SebastianoMeduri/cpld_can_ioexpander/doc/technical_report.html

Report Tecnico · Sviluppo PCB

# I/O Expander su CAN Bus

Intel MAX V · 5M1270ZT144C4 · TQFP-144 · CAN 2.0A @ 500 kbit/s

Controller CAN 2.0A, 32 I/O bidirezionali, funzione di sicurezza a doppio canale e 8 encoder incrementali, interamente in VHDL, sintetizzato e validato in simulazione. Questo documento raccoglie tutto il necessario per il progetto della scheda: pinout, alimentazioni, componenti esterni, temporizzazione e risultati funzionali.

Device5M1270Z

PackageTQFP-144

Clock20 MHz

Bitrate500 kbit/s

Logic~99% (fit)

I/O util.59 pin

Encoder8 × A/B

Sicurezza2 canali

Fault conf.TEC/REC

Sintesi0 errori

SimulazionePASS

Rev. 1.0 Data 2026-07-18 Toolchain Quartus Prime Lite 21.1 Sim GHDL 6.0.0 (VHDL-2008) Convenzione bus 0 = dominante, 1 = recessivo

01 Panoramica

## Architettura del sistema

Il dispositivo si collega al bus CAN tramite un transceiver PHY esterno e mette a disposizione 32 pin configurabili singolarmente come ingresso o uscita, comandabili e leggibili via messaggi CAN. Il protocollo CAN è realizzato interamente nella logica del CPLD (bit timing, bit stuffing, CRC-15, arbitraggio, ACK); non serve alcun microcontrollore né controller CAN dedicato.

Gerarchia RTL. can_ioexpander_top istanzia il controller CAN (sincronizzatore + bit timing + MAC) e l'espansore I/O. Interfaccia fisica a 2 fili (can_txd/can_rxd) verso il transceiver.

02 Target & risorse

## Dispositivo e occupazione

#### Dispositivo

- Famiglia: Intel MAX V (CPLD flash-based, non volatile)
- Part number: 5M1270ZT144C4 (grado C4/C5/A5 intercambiabile — stesso package)
- Logic Element: 1270 · UFM: 8 Kbit (disponibile, non usata)
- Package: TQFP-144, 114 I/O utente
- Config: ISP via JTAG, file .pof (nessuna config flash esterna)

#### Occupazione (post-fit)

Logic cells *~99% *

Pin I/O59 / 114

Interconnessioni~24 % med.

* Con tutte le funzioni la prima sintesi era al 103% (non entrava). Dopo le ottimizzazioni (latch TX rimossi nel MAC; sync I/O a 1FF che abilita il register packing negli IOE) la compilazione ENTRA: Fitter ok, timing rispettato, ~99% (leggere il valore esatto nel fit report). Margine minimo — per headroom vedere le riduzioni in fondo.

### Analisi statica dei tempi (STA) — vincolo clock 20 MHz (50 ns)

Margini positivi su tutti i domini. Il progetto lavora a 20 MHz con ampio margine; nessun percorso critico. Setup +34.4 ns, hold +1.13 ns, min-pulse +24.8 ns.

03 Temporizzazione CAN

## Bit timing — 20 time quanta per bit

Con clock a 20 MHz e prescaler BRP = 2, un time quantum (Tq) vale 100 ns. Il tempo di bit è diviso in 20 Tq (1 SYNC + 15 TSEG1 + 4 TSEG2), pari a 2 µs → 500 kbit/s. Il campionamento avviene all'80 % del bit; la finestra di risincronizzazione (SJW) è 3 Tq.

Parametri configurabili via generic (BRP, TSEG1, TSEG2, SJW) nel top level: per un clock diverso basta ricalcolare BRP affinché 1 bit = NTQ × Tq = 1/bitrate.

04 Formato trama

## Trama dati CAN 2.0A (identificatore standard 11 bit)

Campo dati fino a 8 byte. L'applicazione usa 4 byte (32 bit = i 32 pin). Il CRC-15 (polinomio 0x4599) copre da SOF a fine dati; il bit stuffing agisce su SOF…CRC.

05 Protocollo applicativo

## Messaggi e mappatura dei pin

Identificatore a 11 bit strutturato come FUNC(3) · NODE(4) · 0000. Gli ID esadecimali sotto valgono per node_addr = 0001.

Set di messaggi
Funzione | FUNC | ID (node 1) | Dir. | DLC | Payload
CONFIG | 010 | 0x210 | host → exp | 4 | data[63:32] = maschera direzione (1 = uscita)
OUTPUT | 001 | 0x110 | host → exp | 4 / 8 | data[63:32] = valori uscite; con DLC 8 data[31:0] = maschera di scrittura
REQUEST | 011 | 0x310 | host → exp | 0 | richiede invio immediato dello STATUS
STATUS | 100 | 0x410 | exp → host | 4 | data[63:32] = stato dei pin (uscite pilotate + ingressi letti)

Notifica automatica. Lo STATUS viene inviato spontaneamente al variare di un pin configurato come ingresso — non serve polling. Il REQUEST resta disponibile per una lettura a comando.

Mappatura payload → pin: il pin i corrisponde al bit 32 + i della trama a 64 bit. Byte0 (data[63:56]) = pin 31…24 · Byte1 = pin 23…16 · Byte2 = pin 15…8 · Byte3 = pin 7…0.

06 Pinout — TQFP-144

## Assegnazione dei pin

Layout organizzato per banco: controllo/comunicazione sul banco 1 (un lato del package), 32 I/O contigui sui banchi 3+2 (due lati adiacenti → connettore I/O unico). Banco 4 e i pin liberi restano per espansioni future. Standard I/O: 3.3-V LVTTL.

Segnali di controllo e comunicazione — Banco 1
Segnale | Pin | Dir. | Descrizione
clk | 18 | in | Global clock dedicato — oscillatore 20 MHz
rst_n | 16 | in | Reset asincrono attivo basso
can_rxd | 20 | in | Da RXD del transceiver CAN
can_txd | 21 | out | Verso TXD del transceiver CAN
node_addr[0] | 22 | in | Indirizzo nodo (strap/dip-switch)
node_addr[1] | 23 | in | Indirizzo nodo
node_addr[2] | 24 | in | Indirizzo nodo
node_addr[3] | 27 | in | Indirizzo nodo
led_error | 28 | out | Diagnostica: LED su fault CAN persistente
safe_ch1 | 29 | in | Sicurezza canale 1 (consenso attivo alto, pull-down est.)
safe_ch2 | 30 | in | Sicurezza canale 2 (consenso attivo alto, pull-down est.)

Bus I/O bidirezionale — Banchi 3 + 2 (pin contigui 73…111)
Sig. | Pin | Bank | Sig. | Pin | Bank
io[0] | 73 | 3 | io[16] | 94 | 3
io[1] | 74 | 3 | io[17] | 95 | 3
io[2] | 75 | 3 | io[18] | 96 | 3
io[3] | 76 | 3 | io[19] | 97 | 3
io[4] | 77 | 3 | io[20] | 98 | 3
io[5] | 79 | 3 | io[21] | 101 | 3
io[6] | 80 | 3 | io[22] | 102 | 3
io[7] | 81 | 3 | io[23] | 103 | 3
io[8] | 84 | 3 | io[24] | 104 | 3
io[9] | 85 | 3 | io[25] | 105 | 3
io[10] | 86 | 3 | io[26] | 106 | 3
io[11] | 87 | 3 | io[27] | 107 | 3
io[12] | 88 | 3 | io[28] | 108 | 3
io[13] | 89 | 3 | io[29] | 109 | 2
io[14] | 91 | 3 | io[30] | 110 | 2
io[15] | 93 | 3 | io[31] | 111 | 2

Ingressi non pilotati. I pin usati come ingresso vanno provvisti di resistori di pull esterni (o di una sorgente che li piloti sempre): al reset la direzione di default è ingresso/alta impedenza e i CPLD non tollerano ingressi flottanti.

Funzione di sicurezza (doppio canale fail-safe). safe_ch1 e safe_ch2 sono consensi attivi-alti: le uscite sono abilitate solo se entrambi sono alti. Se uno qualsiasi va basso (E-stop, filo interrotto, mancanza segnale) tutte le uscite vengono forzate a livello basso con override combinatorio, indipendentemente dai comandi CAN; il ripristino è automatico al ritorno del consenso e ogni transizione genera una trama STATUS. Usare pull-down esterni così che la perdita di segnale porti allo stato sicuro.

8 encoder incrementali (quadratura A/B). Ingressi enc_a[7:0] / enc_b[7:0] su banco 4, PIN 37–55 (coppie A/B adiacenti). Decodifica x4, contatori 16-bit con segno, trasmissione periodica su CAN (2 trame ENC_DATA, periodo configurabile via comando) e azzeramento via comando. Per encoder con canale di indice Z servirebbero pin aggiuntivi (non implementato).

07 Alimentazione & pin dedicati

## Alimentazioni, massa e JTAG

Pin di alimentazione / dedicati
Funzione | Tensione | Pin
VCCINT (core) | 1.8 V | 19, 56, 90, 126
VCCIO banco 1 | 3.3 V | 9, 25
VCCIO banco 4 | 3.3 V | 46, 64
VCCIO banco 3 | 3.3 V | 82, 100
VCCIO banco 2 | 3.3 V | 116, 136
GND (I/O) | 0 V | 10,11,26,47,65,78,83,99,115,135
GND (core) | 0 V | 17, 54, 92, 128
JTAG TMS / TDI / TCK / TDO | 3.3 V | 33 / 34 / 35 / 36

#### Regole di scheda

- Due tensioni: 1.8 V (core) e 3.3 V (tutti e 4 i VCCIO). Nessun pin MSEL/config (CPLD flash).
- Disaccoppiamento: 100 nF vicino a ogni pin VCCINT/VCCIO + bulk 4.7–10 µF per rail.
- JTAG: header 10-pin standard Altera per programmazione ISP del .pof.
- Sequenza di accensione: MAX V tollerante; consigliata 1.8 V prima o insieme a 3.3 V.
- Reset: rst_n con RC + eventuale supervisore.

08 Schema di collegamento

## Componenti esterni

BOM minima esterna: transceiver CAN 3.3 V, oscillatore 20 MHz, terminazione 120 Ω (agli estremi del bus), header JTAG, dip-switch indirizzo + pull, resistori di pull sugli I/O usati come ingresso, pull-down sui due ingressi di sicurezza (loss-of-signal → stop), disaccoppiamento.

#### Transceiver

- Scegliere una parte 3.3 V (SN65HVD230, MCP2562FD…) per compatibilità con le VCCIO 3.3 V.
- Terminazione 120 Ω ai due estremi fisici del bus.
- Split-termination + cap opzionale per EMC.

#### Indirizzo & diagnostica

- node_addr[3:0] via dip-switch a 4 vie con pull (definisce l'ID del nodo).
- led_error → LED + resistore di limitazione.
- Prevedere test-point su can_txd/can_rxd per debug con oscilloscopio.

09 Risultati di simulazione

## Validazione funzionale — due nodi su bus wired-AND

Il testbench collega un nodo host e il dispositivo (DUT) sullo stesso bus CAN modellato in wired-AND, ed esercita l'intero stack: framing, arbitraggio, CRC-15, bit stuffing, ACK e la logica applicativa. Esito: tutti i test superati.

Sequenza validata. Ogni trama include l'attesa IFS del nodo trasmittente. Lo STATUS a 652.5 µs è generato spontaneamente dal DUT dopo il cambio dell'ingresso io[0], e ricevuto correttamente dall'host (ACK + CRC ok).

Log della simulazione (GHDL 6.0.0)
t (sim) | Evento | Verifica
40.5 µs | Host invia CONFIG (dir = 0xFFFF0000) | ACK ok
255.7 µs | Host invia OUTPUT (0xBEEF sui pin alti) | ACK ok
477.1 µs | Verifica uscite del DUT | io[31:16] = 0xBEEF ✓
477.1 µs | Forzato ingresso io[0] = 1 | —
652.5 µs | DUT invia STATUS spontaneo, ricevuto dall'host | 0xBEEF0001 ✓
728.5 µs | Iniezione bit/stuff error (bus forzato dominante) | error frame ✓
951.7 µs | Recupero: nuova OUTPUT applicata dopo l'errore | io[31:16] = 0x1234 ✓
1137.8 µs | Trama a ID esteso 29 bit (2.0B passive) | ACK + ignorata ✓
1279 µs | Sicurezza: apertura canale 1 → uscite forzate low | io = 0x0000 ✓
1280 µs | Ripristino + apertura canale 2 (ridondanza) | low + recover ✓
1990 µs | Encoder 0: 8 impulsi avanti → letto via ENC_DATA | enc0 = +8 ✓
2756 µs | ENC_RESET encoder 0 → conteggio azzerato | enc0 = 0 ✓
2756 µs | *** TUTTI I TEST SUPERATI *** (run_exit = 0)

Coperto: SOF · arbitraggio · campo controllo · dati · CRC-15 · bit stuffing/de-stuffing · ACK · EOF · sincronizzazione bit-timing tra nodi indipendenti · CONFIG/OUTPUT/STATUS + notifica automatica · rilevazione errore, error frame e recupero (fault confinement) · tolleranza trame estese 2.0B passive · funzione di sicurezza a doppio canale (uscite a low, auto-ripristino) · 8 encoder in quadratura (conteggio, TX periodica, azzeramento).

10 Note, limiti & roadmap

## Limitazioni note e passi successivi

#### Limitazioni del core

- CAN 2.0A (ID 11 bit) + 2.0B passive: le trame estese 29 bit sono tollerate e confermate ma non trasmesse. La trasmissione di ID estesi non è supportata.
- Fault confinement presente (TEC/REC, error-active/passive/bus-off + recupero, error frame attivi/passivi). Residui: no overload frame, no suspend-transmission 8-bit, regole TEC/REC ridotte.
- Un solo buffer TX / RX (una trama per volta), sufficiente per l'applicazione I/O.

#### Roadmap (già predisposta)

- Configurazione via USB: bridge USB→UART esterno + core UART/registri.
- Persistenza: EEPROM/flash SPI esterna (node_addr, direzioni, default, bitrate).
- Pin liberi riservati: banco 4 e resto del banco 2 → UART + SPI.

Occupazione al limite. Con tutte le funzioni il 5M1270 (il piu' grande MAX V in TQFP-144) e' quasi pieno. Se dopo le ottimizzazioni il Fitter resta >100%, opzioni in ordine di impatto: (1) contatori encoder a 12 bit (−32 LE), (2) rimuovere l'auto-STATUS su cambio ingresso / registro last_rep (−32 LE), (3) capture RX a shift-register, (4) meno I/O o meno encoder, (5) device piu' grande in package diverso (es. MAX 10, richiede redesign scheda).

Stato di maturità. Lato logica il progetto e' funzionalmente completo e validato in simulazione (0 errori, timing OK, tutti i test superati). Da verificare il fit finale in Quartus dopo le ottimizzazioni. I passi rimanenti sono di scheda (transceiver, alimentazioni, connettori, JTAG).

cpld_can_ioexpander · Report tecnico Rev. 1.0 · 2026-07-18 · MAX V 5M1270ZT144 · Generato dai risultati di Quartus Prime Lite 21.1 e GHDL 6.0.0.
