SebastianoMeduri/cpld_can_ioexpander/qt_gui/main.cpp

#include <QGuiApplication>
#include <QQmlApplicationEngine>
#include <QQuickStyle>

int main(int argc, char *argv[])
{
    QGuiApplication app(argc, argv);
    QQuickStyle::setStyle(QStringLiteral("Fusion"));

    QQmlApplicationEngine engine;
    QObject::connect(&engine, &QQmlApplicationEngine::objectCreationFailed,
                     &app, []() { QCoreApplication::exit(-1); }, Qt::QueuedConnection);
    engine.loadFromModule("ExpanderTester", "Main");

    return app.exec();
}
