SebastianoMeduri/cpld_can_ioexpander/sim/tb_can_ioexpander.vhd

--------------------------------------------------------------------------------
-- tb_can_ioexpander.vhd
--
-- Testbench end-to-end:
--   * un nodo "host" (can_controller) invia trame CONFIG / OUTPUT / REQUEST
--   * il DUT (can_ioexpander_top) le riceve, pilota i pin e invia lo STATUS
--   * i due nodi condividono un bus CAN modellato in wired-AND ('0' dominante,
--     'H' recessivo tramite pull-up).
--
-- Scenario:
--   1. CONFIG : pin 31..16 = uscite, pin 15..0 = ingressi
--   2. OUTPUT : scrive 0xBEEF sui pin di uscita (parte alta)
--   3. verifica che io(31..16) = 0xBEEF
--   4. forza un ingresso (io(0)=1) -> il DUT invia STATUS automaticamente
--   5. verifica che l'host riceva lo stato aggiornato
--
-- Simulazione (GHDL):  vedere sim/run_ghdl.sh
--------------------------------------------------------------------------------
library ieee;
use ieee.std_logic_1164.all;
use ieee.numeric_std.all;

library work;
use work.can_pkg.all;

entity tb_can_ioexpander is
end entity tb_can_ioexpander;

architecture sim of tb_can_ioexpander is

  -- 20 MHz -> periodo 50 ns
  constant CLK_PERIOD : time := 50 ns;
  constant BIT_TIME   : time := 2 us;   -- 500 kbit/s

  signal clk    : std_logic := '0';
  signal rst_n  : std_logic := '0';
  signal sim_end: boolean   := false;

  -- bus CAN condiviso
  signal canbus : std_logic;
  signal a_txd, b_txd : std_logic;
  signal a_rxd, b_rxd : std_logic;

  -- interfaccia host (nodo A)
  signal h_txreq  : std_logic := '0';
  signal h_txid   : std_logic_vector(10 downto 0) := (others => '0');
  signal h_txrtr  : std_logic := '0';
  signal h_txdlc  : std_logic_vector(3 downto 0)  := (others => '0');
  signal h_txdata : std_logic_vector(63 downto 0) := (others => '0');
  signal h_txbusy : std_logic;
  signal h_txdone : std_logic;
  signal h_rxvld  : std_logic;
  signal h_rxid   : std_logic_vector(10 downto 0);
  signal h_rxrtr  : std_logic;
  signal h_rxdlc  : std_logic_vector(3 downto 0);
  signal h_rxdata : std_logic_vector(63 downto 0);
  signal h_err    : std_logic;
  signal h_errp   : std_logic;
  signal h_busoff : std_logic;
  signal h_tec    : std_logic_vector(7 downto 0);

  -- iniezione errore / diagnostica
  signal force_dom : std_logic := '0';   -- forza il bus a dominante
  signal seen_err  : std_logic := '0';   -- latch: errore rilevato
  signal clr_err   : std_logic := '0';   -- azzera il latch

  -- generatore di trama estesa (2.0B): '0' = pilota dominante, '1' = rilascia
  signal tb_drive  : std_logic := '1';

  -- DUT (nodo B)
  signal node_addr : std_logic_vector(3 downto 0) := "0001";
  signal safe_ch1  : std_logic := '1';   -- consenso sicurezza (attivo alto)
  signal safe_ch2  : std_logic := '1';
  signal enc_a     : std_logic_vector(7 downto 0) := (others => '0');
  signal enc_b     : std_logic_vector(7 downto 0) := (others => '0');
  -- pattern ADC di test: ch0=0x0AAA, ch1=0x0555, resto 0 (12 bit utili per canale)
  signal adc_val   : std_logic_vector(127 downto 0) :=
      x"00000000000000000000000005550AAA";
  signal io        : std_logic_vector(31 downto 0);
  signal tb_io_drv : std_logic_vector(31 downto 0) := (others => 'Z');
  signal led_err   : std_logic;

  -- identificatori
  constant ID_CONFIG : std_logic_vector(10 downto 0) := "010" & "0001" & "0000";
  constant ID_OUTPUT : std_logic_vector(10 downto 0) := "001" & "0001" & "0000";
  constant ID_STATUS : std_logic_vector(10 downto 0) := "100" & "0001" & "0000";
  constant ID_ENCPER : std_logic_vector(10 downto 0) := "000" & "0001" & "0000";
  constant ID_ENCRST : std_logic_vector(10 downto 0) := "101" & "0001" & "0000";
  constant ID_ENC0   : std_logic_vector(10 downto 0) := "110" & "0001" & "0000";
  constant ID_ANA0   : std_logic_vector(10 downto 0) := "111" & "0001" & "0000";
  constant ID_THR0   : std_logic_vector(10 downto 0) := "010" & "0001" & "0001"; -- CONFIG SUB=1
  constant ID_THR1   : std_logic_vector(10 downto 0) := "010" & "0001" & "0010"; -- CONFIG SUB=2
  constant ID_ACMP   : std_logic_vector(10 downto 0) := "111" & "0001" & "0010"; -- ANALOG SUB=2

begin

  ----------------------------------------------------------------------------
  -- Clock
  ----------------------------------------------------------------------------
  clk <= not clk after CLK_PERIOD/2 when not sim_end else '0';

  ----------------------------------------------------------------------------
  -- Bus CAN in wired-AND: dominante '0' prevale, altrimenti pull-up 'H'.
  ----------------------------------------------------------------------------
  canbus <= 'H';
  canbus <= '0' when a_txd = '0' else 'Z';
  canbus <= '0' when b_txd = '0' else 'Z';
  canbus <= '0' when force_dom = '1' else 'Z';   -- iniezione errore
  canbus <= '0' when tb_drive  = '0' else 'Z';   -- generatore trama estesa
  a_rxd  <= to_x01(canbus);
  b_rxd  <= to_x01(canbus);

  -- pilotaggio dei pin dal testbench (solo gli ingressi del DUT)
  io <= tb_io_drv;
  -- pull-down debole: i pin non pilotati si leggono come '0' (evita 'X')
  io <= (others => 'L');

  ----------------------------------------------------------------------------
  -- Nodo A: host
  ----------------------------------------------------------------------------
  u_host : entity work.can_controller
    port map (
      clk        => clk,
      rst_n      => rst_n,
      can_rx     => a_rxd,
      can_tx     => a_txd,
      tx_request => h_txreq,
      tx_id      => h_txid,
      tx_rtr     => h_txrtr,
      tx_dlc     => h_txdlc,
      tx_data    => h_txdata,
      tx_busy    => h_txbusy,
      tx_done    => h_txdone,
      rx_valid   => h_rxvld,
      rx_id      => h_rxid,
      rx_rtr     => h_rxrtr,
      rx_dlc     => h_rxdlc,
      rx_data    => h_rxdata,
      error_flag    => h_err,
      error_passive => h_errp,
      bus_off       => h_busoff,
      tec_value     => h_tec
    );

  -- latch dell'evento di errore rilevato dal nodo host
  errlatch : process (clk)
  begin
    if rising_edge(clk) then
      if clr_err = '1' then
        seen_err <= '0';
      elsif h_err = '1' then
        seen_err <= '1';
      end if;
    end if;
  end process;

  ----------------------------------------------------------------------------
  -- Nodo B: DUT (I/O expander)
  ----------------------------------------------------------------------------
  u_dut : entity work.can_ioexpander_top
    generic map (MS_TICKS => 20, ENC_PERIOD_MS => 0,    -- ms veloce, periodico off all'avvio
                 ADC_PRESENT => true)                   -- abilita la trasmissione ANALOG
    port map (
      clk       => clk,
      rst_n     => rst_n,
      can_rxd   => b_rxd,
      can_txd   => b_txd,
      node_addr => node_addr,
      safe_ch1  => safe_ch1,
      safe_ch2  => safe_ch2,
      enc_a     => enc_a,
      enc_b     => enc_b,
      adc_val   => adc_val,
      io        => io,
      led_error => led_err
    );

  ----------------------------------------------------------------------------
  -- Stimoli
  ----------------------------------------------------------------------------
  stim : process

    -- invia una trama dal nodo host e attende l'ACK (tx_done)
    procedure host_send (id   : std_logic_vector(10 downto 0);
                         dlc  : std_logic_vector(3 downto 0);
                         data : std_logic_vector(63 downto 0)) is
    begin
      h_txid   <= id;
      h_txrtr  <= '0';
      h_txdlc  <= dlc;
      h_txdata <= data;
      h_txreq  <= '1';
      wait until h_txdone = '1' for 3 ms;
      assert h_txdone = '1'
        report "TIMEOUT: la trama host non e' stata confermata (ACK mancante)"
        severity failure;
      h_txreq <= '0';
      wait for 20 * BIT_TIME;   -- lascia passare EOF/IFS e tempo di idle
    end procedure;

    -- Genera sul bus una trama DATI a identificatore ESTESO (CAN 2.0B, DLC=0),
    -- con bit stuffing e CRC-15 calcolati qui, e campiona lo slot di ACK.
    -- ack_ok = true se almeno un nodo ha confermato (ACK dominante).
    procedure send_ext (base_id : std_logic_vector(10 downto 0);
                        ext_id  : std_logic_vector(17 downto 0);
                        ext     : boolean;
                        ack_ok  : out boolean) is
      variable fields : std_logic_vector(0 to 63);
      variable n   : integer := 0;
      variable crc : std_logic_vector(14 downto 0) := (others => '0');
      variable rv  : std_logic := '0';
      variable rl  : integer := 0;
      variable a   : std_logic;

      procedure put (b : std_logic) is           -- accoda bit di campo + CRC
      begin
        fields(n) := b; n := n + 1;
        crc := crc15_next(crc, b);
      end procedure;

      procedure hold (b : std_logic) is           -- pilota un bit-time
      begin
        tb_drive <= b;
        wait for BIT_TIME;
      end procedure;
    begin
      -- costruzione campi grezzi SOF..DLC (DLC=0 -> nessun dato)
      put('0');                                            -- SOF
      for i in 10 downto 0 loop put(base_id(i)); end loop; -- Base ID
      if ext then
        put('1');                                          -- SRR (recessivo)
        put('1');                                          -- IDE (recessivo -> esteso)
        for i in 17 downto 0 loop put(ext_id(i)); end loop;-- ID esteso
        put('0');                                          -- RTR
        put('0');                                          -- r1
        put('0');                                          -- r0
      else
        put('0');                                          -- RTR
        put('0');                                          -- IDE (dominante -> standard)
        put('0');                                          -- r0
      end if;
      put('0'); put('0'); put('0'); put('0');              -- DLC = 0
      for i in 14 downto 0 loop                            -- CRC (non rientra nel CRC)
        fields(n) := crc(i); n := n + 1;
      end loop;

      tb_drive <= '1';
      wait for 4 * BIT_TIME;                               -- idle recessivo

      -- invio con bit stuffing su tutta la regione SOF..CRC
      rl := 0; rv := '0';
      for i in 0 to n - 1 loop
        if rl = 5 then
          hold(not rv); rv := not rv; rl := 1;             -- bit di stuffing
        end if;
        hold(fields(i));
        if fields(i) = rv then rl := rl + 1; else rv := fields(i); rl := 1; end if;
      end loop;
      if rl = 5 then hold(not rv); end if;                 -- eventuale stuff finale

      hold('1');                                           -- CRC delimiter
      -- ACK slot: rilascia e campiona all'80%
      tb_drive <= '1';
      wait for (BIT_TIME * 4) / 5;
      a := to_x01(canbus);
      wait for BIT_TIME / 5;
      ack_ok := (a = '0');
      for i in 0 to 10 loop hold('1'); end loop;           -- ACK delim + EOF(7) + IFS(3)
      tb_drive <= '1';
    end procedure;

    -- avanza di un passo la quadratura dell'encoder 0 (fwd=avanti)
    procedure enc0_step (fwd : boolean) is
      variable ab : std_logic_vector(1 downto 0);
    begin
      ab := to_x01(enc_a(0)) & to_x01(enc_b(0));
      if fwd then
        case ab is
          when "00"   => ab := "01";
          when "01"   => ab := "11";
          when "11"   => ab := "10";
          when others => ab := "00";
        end case;
      else
        case ab is
          when "00"   => ab := "10";
          when "10"   => ab := "11";
          when "11"   => ab := "01";
          when others => ab := "00";
        end case;
      end if;
      enc_a(0) <= ab(1);
      enc_b(0) <= ab(0);
      wait for 15 * CLK_PERIOD;
    end procedure;

    variable ext_ack : boolean;
    variable rxd     : std_logic_vector(63 downto 0);
    variable got     : boolean;

  begin
    -- pin bassi (ingressi) pilotati a 0 dal testbench, pin alti in alta impedenza
    tb_io_drv <= (31 downto 16 => 'Z', others => '0');

    -- reset
    rst_n <= '0';
    wait for 10 * CLK_PERIOD;
    rst_n <= '1';
    wait for 20 * BIT_TIME;

    ------------------------------------------------------------------------
    -- 1) CONFIG: pin 31..16 uscite (dir=1), pin 15..0 ingressi (dir=0)
    ------------------------------------------------------------------------
    report "TB: invio CONFIG (dir = 0xFFFF0000)";
    host_send(ID_CONFIG, "0100", x"FFFF0000" & x"00000000");

    ------------------------------------------------------------------------
    -- 2) OUTPUT: scrive 0xBEEF sui pin alti
    ------------------------------------------------------------------------
    report "TB: invio OUTPUT (pin word = 0xBEEF0000)";
    host_send(ID_OUTPUT, "0100", x"BEEF0000" & x"00000000");
    wait for 5 * BIT_TIME;

    ------------------------------------------------------------------------
    -- 3) verifica delle uscite
    ------------------------------------------------------------------------
    assert to_x01(io(31 downto 16)) = x"BEEF"
      report "FAIL: uscite errate, atteso 0xBEEF, letto 0x" &
             to_hstring(to_x01(io(31 downto 16)))
      severity failure;
    report "TB: OK uscite = 0xBEEF";

    ------------------------------------------------------------------------
    -- 4) variazione ingresso -> STATUS automatico
    ------------------------------------------------------------------------
    report "TB: forzo io(0)=1, attendo STATUS dal DUT";
    tb_io_drv(0) <= '1';

    wait until h_rxvld = '1' for 3 ms;
    assert h_rxvld = '1'
      report "TIMEOUT: nessuno STATUS ricevuto dal DUT" severity failure;

    assert h_rxid = ID_STATUS
      report "FAIL: ID STATUS errato" severity failure;

    -- stato atteso: uscite 0xBEEF (parte alta) + ingresso pin0 = 1
    assert h_rxdata(63 downto 32) = x"BEEF0001"
      report "FAIL: STATUS errato, atteso 0xBEEF0001, letto 0x" &
             to_hstring(h_rxdata(63 downto 32))
      severity failure;
    report "TB: OK STATUS = 0xBEEF0001";

    ------------------------------------------------------------------------
    -- 5) iniezione bit/stuff error e verifica del recupero
    ------------------------------------------------------------------------
    report "TB: iniezione errore (bus forzato dominante per 8 bit)";
    force_dom <= '1';
    wait for 8 * BIT_TIME;
    force_dom <= '0';
    wait for 30 * BIT_TIME;         -- attende error frame + recupero a idle

    assert seen_err = '1'
      report "FAIL: l'errore iniettato non e' stato rilevato" severity failure;
    report "TB: OK errore rilevato dal MAC (error frame emesso)";

    -- recupero: una nuova trama deve essere trasmessa e applicata
    report "TB: verifica recupero post-errore (OUTPUT = 0x1234)";
    host_send(ID_OUTPUT, "0100", x"12340000" & x"00000000");
    wait for 5 * BIT_TIME;
    assert to_x01(io(31 downto 16)) = x"1234"
      report "FAIL: nessun recupero dopo l'errore, uscite = 0x" &
             to_hstring(to_x01(io(31 downto 16))) severity failure;
    report "TB: OK recupero dopo errore, uscite = 0x1234";

    ------------------------------------------------------------------------
    -- 6) CAN 2.0B passive: trama a ID esteso -> confermata ma ignorata
    ------------------------------------------------------------------------
    report "TB: invio trama a identificatore ESTESO (29 bit)";
    clr_err <= '1'; wait for CLK_PERIOD; clr_err <= '0';
    send_ext("10101010101", "110011001100110011", true, ext_ack);
    wait for 20 * BIT_TIME;

    assert ext_ack
      report "FAIL: la trama estesa non e' stata confermata (ACK assente)"
      severity failure;
    assert seen_err = '0'
      report "FAIL: la trama estesa ha generato un errore nel MAC"
      severity failure;
    assert to_x01(io(31 downto 16)) = x"1234"
      report "FAIL: la trama estesa ha alterato le uscite (atteso 0x1234, letto 0x" &
             to_hstring(to_x01(io(31 downto 16))) & ")"
      severity failure;
    report "TB: OK trama estesa confermata (ACK) e ignorata dall'applicazione";

    ------------------------------------------------------------------------
    -- 7) Funzione di sicurezza (doppio canale fail-safe, auto-ripristino)
    ------------------------------------------------------------------------
    assert to_x01(io(31 downto 16)) = x"1234"
      report "FAIL: uscite non attive prima del test sicurezza" severity failure;

    report "TB: sicurezza - apro il canale 1 (safe_ch1=0)";
    safe_ch1 <= '0';
    wait for 12 * CLK_PERIOD;
    assert to_x01(io(31 downto 16)) = x"0000"
      report "FAIL: uscite non forzate a low con safe_ch1=0" severity failure;
    report "TB: OK uscite forzate a low (canale 1)";
    safe_ch1 <= '1';
    wait for 12 * CLK_PERIOD;
    assert to_x01(io(31 downto 16)) = x"1234"
      report "FAIL: nessun auto-ripristino dopo safe_ch1" severity failure;
    report "TB: OK auto-ripristino uscite = 0x1234";

    report "TB: sicurezza - apro il canale 2 (safe_ch2=0)";
    safe_ch2 <= '0';
    wait for 12 * CLK_PERIOD;
    assert to_x01(io(31 downto 16)) = x"0000"
      report "FAIL: uscite non forzate a low con safe_ch2=0" severity failure;
    report "TB: OK uscite forzate a low (canale 2) - ridondanza confermata";
    safe_ch2 <= '1';
    wait for 12 * CLK_PERIOD;
    assert to_x01(io(31 downto 16)) = x"1234"
      report "FAIL: nessun auto-ripristino dopo safe_ch2" severity failure;
    report "TB: OK sicurezza fail-safe validata (auto-ripristino)";

    ------------------------------------------------------------------------
    -- 8) Encoder: quadratura, trasmissione periodica e azzeramento
    ------------------------------------------------------------------------
    report "TB: encoder - genero 8 impulsi AVANTI su encoder 0";
    for k in 1 to 8 loop
      enc0_step(true);
    end loop;

    report "TB: abilito la trasmissione periodica encoder (ENC_PERIOD)";
    host_send(ID_ENCPER, "0100", x"0064" & x"0000" & x"00000000");  -- periodo 100 (ms fittizi)

    -- attende una trama ENC_DATA blocco 0 e verifica il conteggio di encoder 0
    got := false;
    while not got loop
      wait until h_rxvld = '1' for 4 ms;
      assert h_rxvld = '1' report "TIMEOUT: nessuna trama ENC_DATA ricevuta" severity failure;
      if h_rxid = ID_ENC0 then
        rxd := h_rxdata;
        got := true;
      end if;
      wait for CLK_PERIOD;
    end loop;
    assert rxd(63 downto 48) = x"0008"
      report "FAIL: conteggio encoder 0 errato, atteso 0x0008, letto 0x" &
             to_hstring(rxd(63 downto 48)) severity failure;
    report "TB: OK encoder 0 = +8 ricevuto via CAN (ENC_DATA)";

    report "TB: azzeramento encoder 0 (ENC_RESET)";
    host_send(ID_ENCRST, "1000", x"0000000000000001");   -- data[7:0] bit0 -> azzera enc0

    got := false;
    while not got loop
      wait until h_rxvld = '1' for 4 ms;
      assert h_rxvld = '1' report "TIMEOUT: nessuna trama ENC_DATA dopo reset" severity failure;
      if h_rxid = ID_ENC0 then
        rxd := h_rxdata;
        got := true;
      end if;
      wait for CLK_PERIOD;
    end loop;
    assert rxd(63 downto 48) = x"0000"
      report "FAIL: encoder 0 non azzerato, letto 0x" &
             to_hstring(rxd(63 downto 48)) severity failure;
    report "TB: OK encoder 0 azzerato via CAN";

    ------------------------------------------------------------------------
    -- 9) Letture ADC (messaggio ANALOG) — periodico gia' abilitato
    ------------------------------------------------------------------------
    report "TB: attendo trama ANALOG (blocco 0)";
    got := false;
    while not got loop
      wait until h_rxvld = '1' for 4 ms;
      assert h_rxvld = '1' report "TIMEOUT: nessuna trama ANALOG ricevuta" severity failure;
      if h_rxid = ID_ANA0 then
        rxd := h_rxdata;
        got := true;
      end if;
      wait for CLK_PERIOD;
    end loop;
    assert rxd(63 downto 48) = x"0AAA" and rxd(47 downto 32) = x"0555"
      report "FAIL: letture ADC errate, atteso ch0=0x0AAA ch1=0x0555, letto ch0=0x" &
             to_hstring(rxd(63 downto 48)) & " ch1=0x" & to_hstring(rxd(47 downto 32))
      severity failure;
    report "TB: OK letture ADC via CAN (ch0=0x0AAA, ch1=0x0555)";

    ------------------------------------------------------------------------
    -- 10) Soglie ADC configurabili + bitmap di confronto (ANALOG SUB=2)
    --     adc: ch0=0x0AAA(2730), ch1=0x0555(1365), ch2..7=0
    --     soglie: ch0=0x0500 -> 1, ch1=0x0800 -> 0, ch2..7=0x0001 -> 0
    --     bitmap atteso = 0x01 (solo canale 0 sopra soglia)
    ------------------------------------------------------------------------
    report "TB: configuro soglie ADC (CONFIG SUB=1/2)";
    host_send(ID_THR0, "1000", x"0500" & x"0800" & x"0001" & x"0001"); -- ch0..3
    host_send(ID_THR1, "1000", x"0001" & x"0001" & x"0001" & x"0001"); -- ch4..7

    report "TB: attendo bitmap di confronto (ANALOG SUB=2)";
    got := false;
    while not got loop
      wait until h_rxvld = '1' for 4 ms;
      assert h_rxvld = '1' report "TIMEOUT: nessun bitmap di confronto ricevuto" severity failure;
      if h_rxid = ID_ACMP then
        rxd := h_rxdata;
        got := true;
      end if;
      wait for CLK_PERIOD;
    end loop;
    assert rxd(63 downto 56) = x"01"
      report "FAIL: bitmap confronto errato, atteso 0x01, letto 0x" &
             to_hstring(rxd(63 downto 56)) severity failure;
    report "TB: OK bitmap confronto soglie = 0x01 (solo ch0 sopra soglia)";

    report "TB: *** TUTTI I TEST SUPERATI ***" severity note;
    sim_end <= true;
    wait;
  end process;

end architecture sim;
