SebastianoMeduri/cpld_can_ioexpander/(commit log)

2026-07-18 Added bus error management
    [can_controller.vhd, can_ioexpander_top.vhd, can_mac.vhd, tb_can_ioexpander.vhd]
2026-07-18 added esp32 driver
2026-07-18 Added C# GUI for test device
